JonasRadtke/128x32_VFD_Badge/128x32_VFD_Badge.kicad_pcb

## KiCad design 128x32_VFD_Badge.kicad_pcb (2025-07-06)

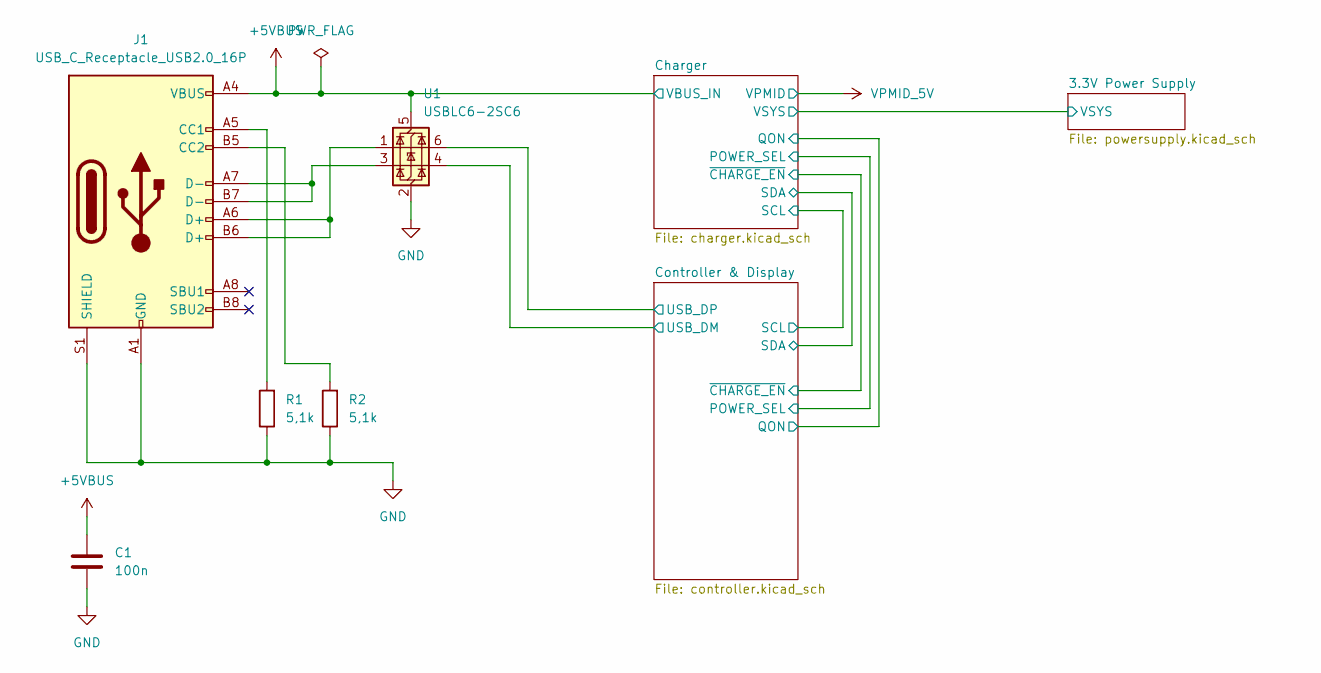
[picture p1: schematic 128x32_VFD_Badge.kicad_sch]

Parts:
C1: 100n; C_0603_1608Metric; Voltage 5V
J1: USB_C_Receptacle_USB2.0_16P; TYPE-C-31-M-14
R1, R2: 5,1k; R_0603_1608Metric
U1: USBLC6-2SC6; SOT-23-6

Connections:
+5VBUS: C1.1, J1.A4 (VBUS), J1.A9 (VBUS), J1.B4 (VBUS), J1.B9 (VBUS), U1.5 (VBUS); also elsewhere on the board
/Controller & Display/USB_DM: U1.4 (I/O2); also elsewhere on the board
/Controller & Display/USB_DP: U1.6 (I/O1); also elsewhere on the board
GND: C1.2, J1.A1 (GND), J1.A12 (GND), J1.B1 (GND), J1.B12 (GND), J1.S1 (SHIELD), R1.1, R2.1, U1.2 (GND); also elsewhere on the board
unnamed: J1.A5 (CC1), R1.2
unnamed: J1.B5 (CC2), R2.2
unnamed: J1.A6 (D+), J1.B6 (D+), U1.1 (I/O1)
unnamed: J1.A7 (D-), J1.B7 (D-), U1.3 (I/O2)

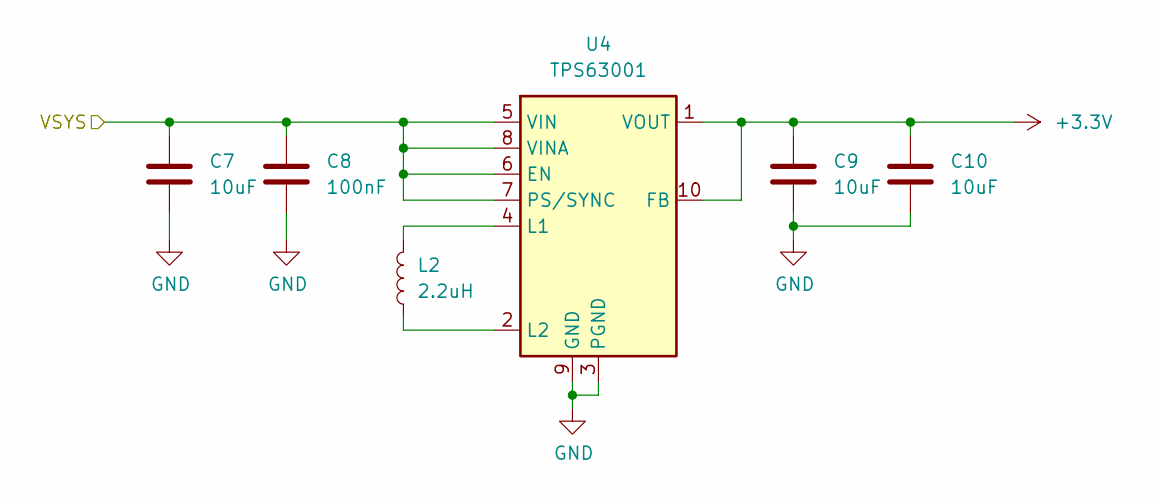
[picture p2: schematic powersupply.kicad_sch]

Parts:
C7, C9, C10: 10uF; C_0603_1608Metric; Voltage 10V
C8: 100nF; C_0603_1608Metric; Voltage 10V
L2: 2.2uH; L_Vishay_IHLP-1616
U4: TPS63001; Texas_DRC0010J_ThermalVias

Connections:
+3.3V: C9.1, C10.1, U4.1 (VOUT), U4.10 (FB); also elsewhere on the board
/3.3V Power Supply/VSYS: C7.1, C8.1, U4.5 (VIN), U4.6 (EN), U4.7 (PS/SYNC), U4.8 (VINA); also elsewhere on the board
GND: C7.2, C8.2, C9.2, C10.2, U4.3 (PGND), U4.9 (GND), U4.11 (PGND); also elsewhere on the board
unnamed: L2.2, U4.4 (L1)
unnamed: L2.1, U4.2 (L2)

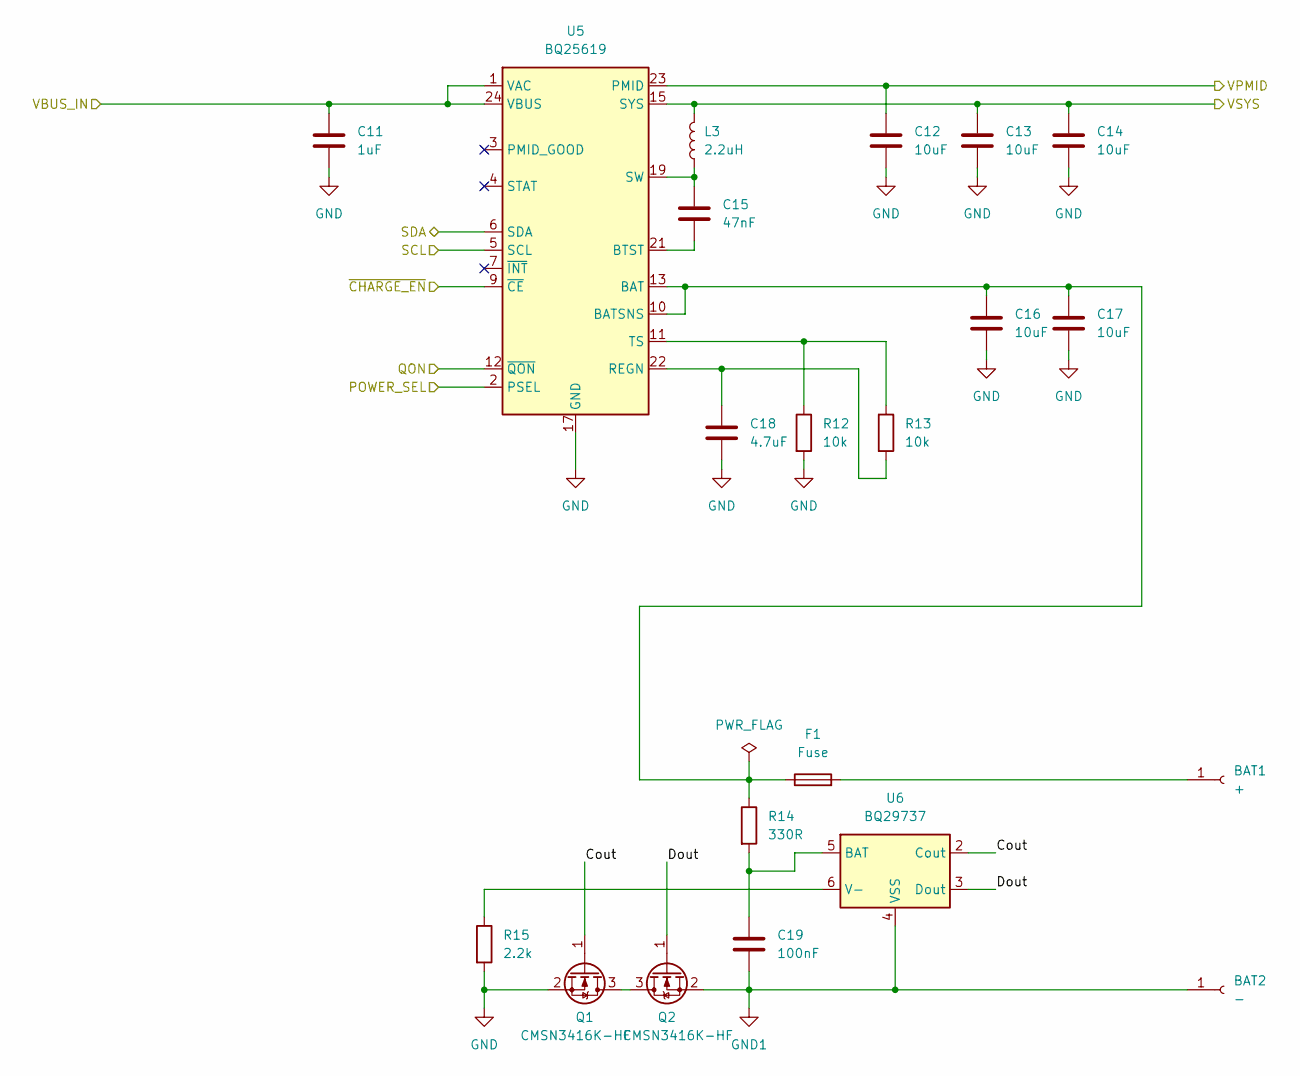
[picture p3: schematic charger.kicad_sch]

Parts:
BAT1: +; BatteryClip_Keystone_54_D16-19mm
BAT2: -; BatteryClip_Keystone_54_D16-19mm
C11: 1uF; C_0603_1608Metric; Voltage 10V
C12, C13, C14, C16, C17: 10uF; C_0603_1608Metric; Voltage 10V
C15: 47nF; C_0603_1608Metric
C18: 4.7uF; C_0603_1608Metric; Voltage 10V
C19: 100nF; C_0603_1608Metric; Voltage 10V
F1: Fuse; Fuse_1206_3216Metric
L3: 2.2uH; L_Vishay_IHLP-1616
Q1, Q2: CMSN3416K-HF; SOT-23
R12, R13: 10k; R_0603_1608Metric
R14: 330R; R_0603_1608Metric
R15: 2.2k; R_0603_1608Metric
U5: BQ25619; WQFN-24-1EP_4x4mm_P0.5mm_EP2.6x2.6mm_ThermalVias
U6: BQ29737; WSON-6_1.5x1.5mm_P0.5mm

Connections:
+5VBUS: C11.1, U5.1 (VAC), U5.24 (VBUS); also elsewhere on the board
/3.3V Power Supply/VSYS: C13.1, C14.1, L3.2, U5.15 (SYS), U5.16 (SYS); also elsewhere on the board
/Charger/Cout: Q1.1 (G), U6.2 (Cout)
/Charger/Dout: Q2.1 (G), U6.3 (Dout)
/Charger/POWER_SEL: U5.2 (PSEL); also elsewhere on the board
/Charger/QON: U5.12 (~QON); also elsewhere on the board
/Charger/SCL: U5.5 (SCL); also elsewhere on the board
/Charger/SDA: U5.6 (SDA); also elsewhere on the board
/Charger/~CHARGE_EN: U5.9 (~CE); also elsewhere on the board
BAT: C16.1, C17.1, F1.1, R14.1, U5.10 (BATSNS), U5.13 (BAT), U5.14 (BAT)
GND: C11.2, C12.2, C13.2, C14.2, C16.2, C17.2, C18.2, Q1.2 (S), R12.2, R15.2, U5.17 (GND), U5.18 (GND), U5.25 (GND); also elsewhere on the board
GND1: BAT2.1, C19.2, Q2.2 (S), U6.4 (VSS)
unnamed: BAT1.1, F1.2
unnamed: C15.1, L3.1, U5.19 (SW), U5.20 (SW)
unnamed: Q1.3 (D), Q2.3 (D)
unnamed: C15.2, U5.21 (BTST)
unnamed: C18.1, R13.2, U5.22 (REGN)
unnamed: R12.1, R13.1, U5.11 (TS)
unnamed: C19.1, R14.2, U6.5 (BAT)
unnamed: R15.1, U6.6 (V-)
VPMID_5V: C12.1, U5.23 (PMID); also elsewhere on the board

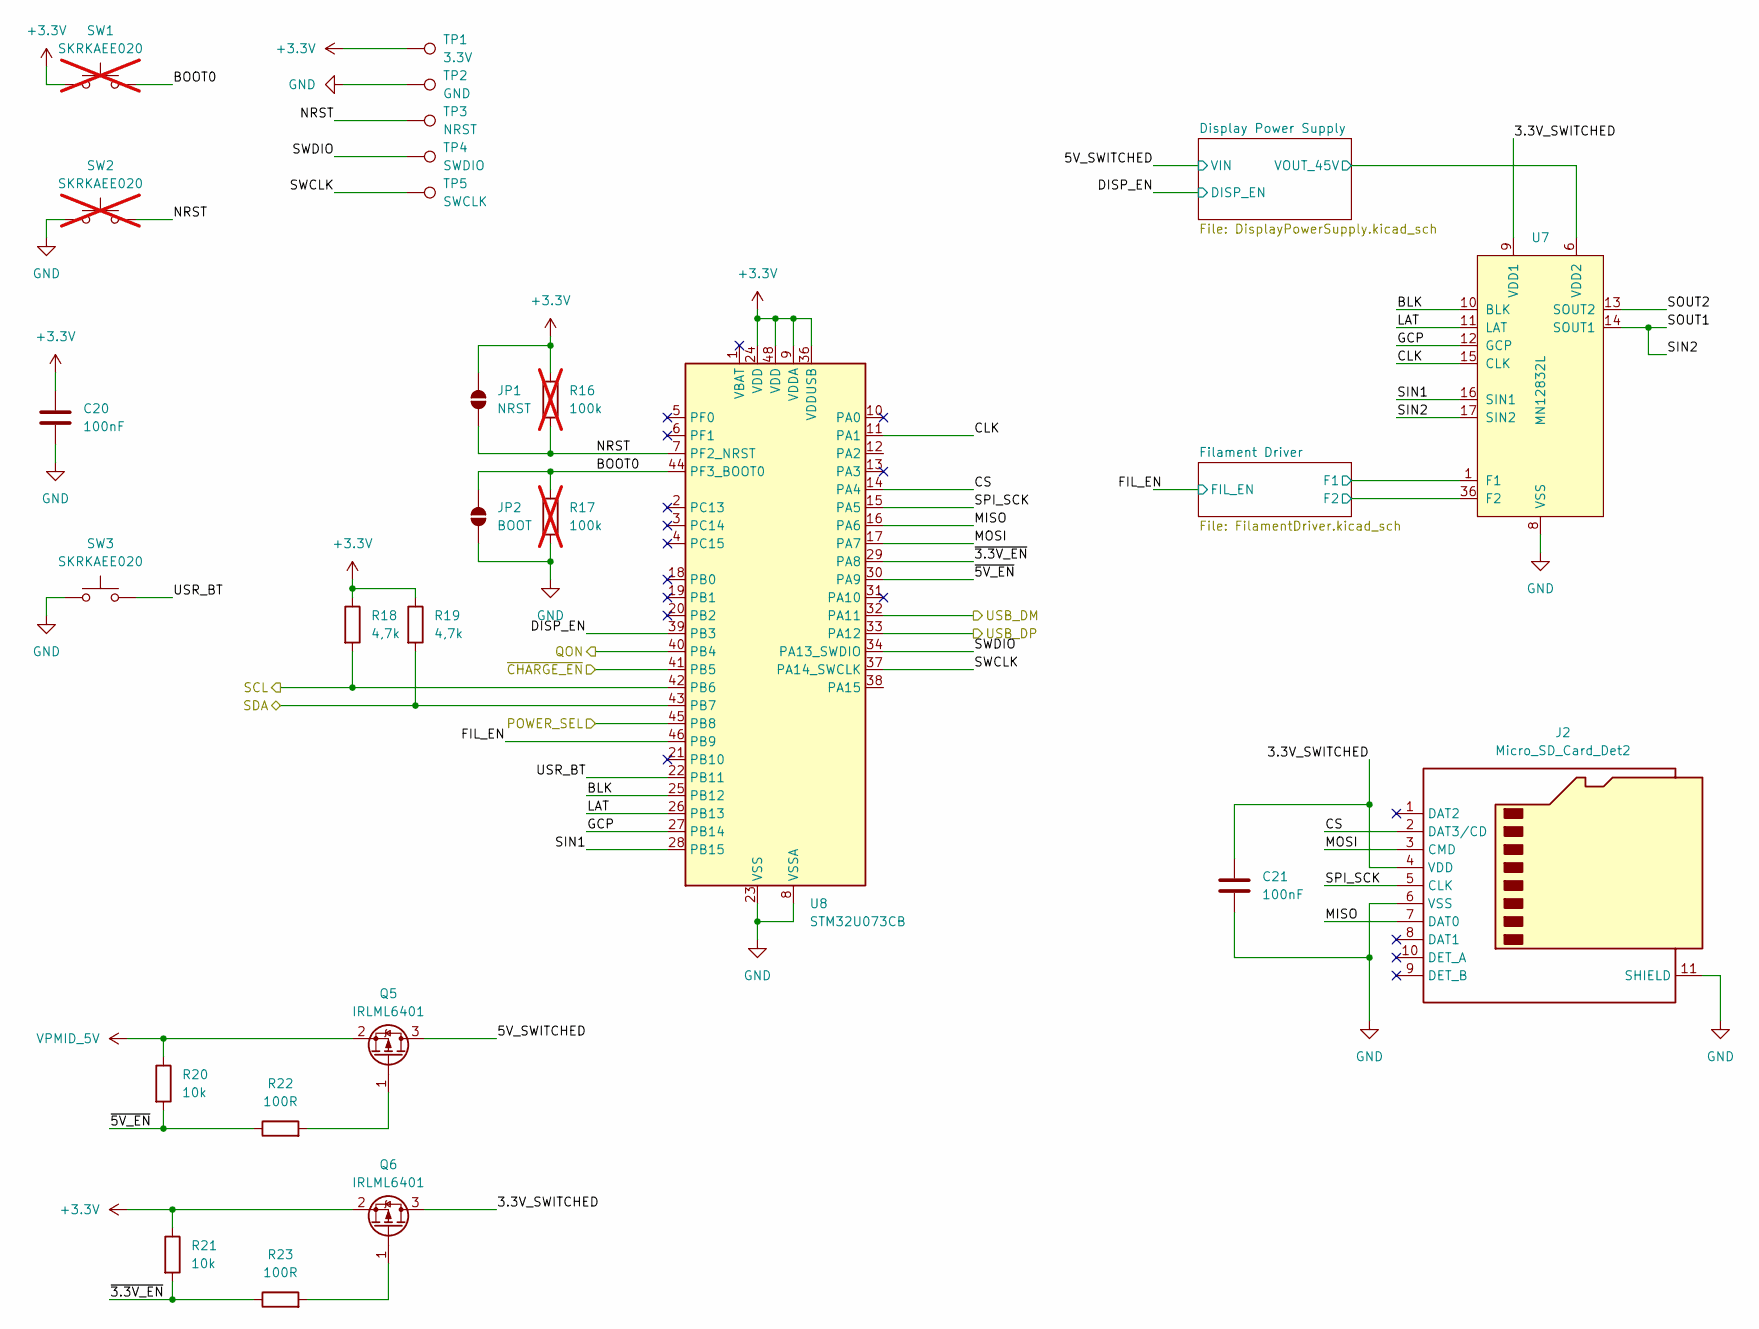
[picture p4: schematic controller.kicad_sch]

Parts:
C20, C21: 100nF; C_0603_1608Metric; Voltage 10V
J2: Micro_SD_Card_Det2; microSD_HC_Molex_104031-0811
JP1: NRST; SolderJumper-2_P1.3mm_Open_TrianglePad1.0x1.5mm
JP2: BOOT; SolderJumper-2_P1.3mm_Open_TrianglePad1.0x1.5mm
Q5, Q6: IRLML6401; SOT-23
R16, R17: 100k; R_0603_1608Metric; not fitted
R18, R19: 4,7k; R_0603_1608Metric
R20, R21: 10k; R_0603_1608Metric
R22, R23: 100R; R_0603_1608Metric
SW1, SW2: SKRKAEE020; SW_Push_SPST_NO_Alps_SKRK; not fitted
SW3: SKRKAEE020; SW_Push_SPST_NO_Alps_SKRK
TP1: 3.3V; TestPoint_Pad_D1.0mm
TP2: GND; TestPoint_Pad_D1.0mm
TP3: NRST; TestPoint_Pad_D1.0mm
TP4: SWDIO; TestPoint_Pad_D1.0mm
TP5: SWCLK; TestPoint_Pad_D1.0mm
U7: MN12832L
U8: STM32U073CB; LQFP-48_7x7mm_P0.5mm

Connections:
+3.3V: C20.1, JP1.2 (B), Q6.2 (S), R16.1, R18.1, R19.1, R21.1, SW1.1, TP1.1, U8.9 (VDDA), U8.24 (VDD), U8.36 (VDDUSB), U8.48 (VDD); also elsewhere on the board
+45V: U7.6 (VDD2); also elsewhere on the board
/Charger/POWER_SEL: U8.45 (PB8); also elsewhere on the board
/Charger/QON: U8.40 (PB4); also elsewhere on the board
/Charger/SCL: R18.2, U8.42 (PB6); also elsewhere on the board
/Charger/SDA: R19.2, U8.43 (PB7); also elsewhere on the board
/Charger/~CHARGE_EN: U8.41 (PB5); also elsewhere on the board
/Controller & Display/3.3V_SWITCHED: C21.1, J2.4 (VDD), Q6.3 (D), U7.9 (VDD1)
/Controller & Display/5V_SWITCHED: Q5.3 (D); also elsewhere on the board
/Controller & Display/BLK: U7.10 (BLK), U8.25 (PB12)
/Controller & Display/BOOT0: JP2.2 (B), R17.1, SW1.2, U8.44 (PF3_BOOT0)
/Controller & Display/CLK: U7.15 (CLK), U8.11 (PA1)
/Controller & Display/CS: J2.2 (DAT3/CD), U8.14 (PA4)
/Controller & Display/DISP_EN: U8.39 (PB3); also elsewhere on the board
/Controller & Display/FIL_EN: U8.46 (PB9); also elsewhere on the board
/Controller & Display/Filament Driver/F1: U7.1 (F1), U7.2 (F1), U7.3 (F1); also elsewhere on the board
/Controller & Display/Filament Driver/F2: U7.36 (F2), U7.37 (F1), U7.38 (F1); also elsewhere on the board
/Controller & Display/GCP: U7.12 (GCP), U8.27 (PB14)
/Controller & Display/LAT: U7.11 (LAT), U8.26 (PB13)
/Controller & Display/MISO: J2.7 (DAT0), U8.16 (PA6)
/Controller & Display/MOSI: J2.3 (CMD), U8.17 (PA7)
/Controller & Display/NRST: JP1.1 (A), R16.2, SW2.2, TP3.1, U8.7 (PF2_NRST)
/Controller & Display/SIN1: U7.16 (SIN1), U8.28 (PB15)
/Controller & Display/SIN2: U7.14 (SOUT1), U7.17 (SIN2)
/Controller & Display/SOUT2: U7.13 (SOUT2)
/Controller & Display/SPI_SCK: J2.5 (CLK), U8.15 (PA5)
/Controller & Display/SWCLK: TP5.1, U8.37 (PA14_SWCLK)
/Controller & Display/SWDIO: TP4.1, U8.34 (PA13_SWDIO)
/Controller & Display/USB_DM: U8.32 (PA11); also elsewhere on the board
/Controller & Display/USB_DP: U8.33 (PA12); also elsewhere on the board
/Controller & Display/USR_BT: SW3.2, U8.22 (PB11)
/Controller & Display/~3.3V_EN: R21.2, R23.1, U8.29 (PA8)
/Controller & Display/~5V_EN: R20.2, R22.1, U8.30 (PA9)
GND: C20.2, C21.2, J2.6 (VSS), J2.11 (SHIELD), JP2.1 (A), R17.2, SW2.1, SW3.1, TP2.1, U7.7 (VSS), U7.8 (VSS), U8.8 (VSSA), U8.23 (VSS), U8.35 (VSS), U8.47 (VSS); also elsewhere on the board
unnamed: Q5.1 (G), R22.2
unnamed: Q6.1 (G), R23.2
VPMID_5V: Q5.2 (S), R20.1; also elsewhere on the board

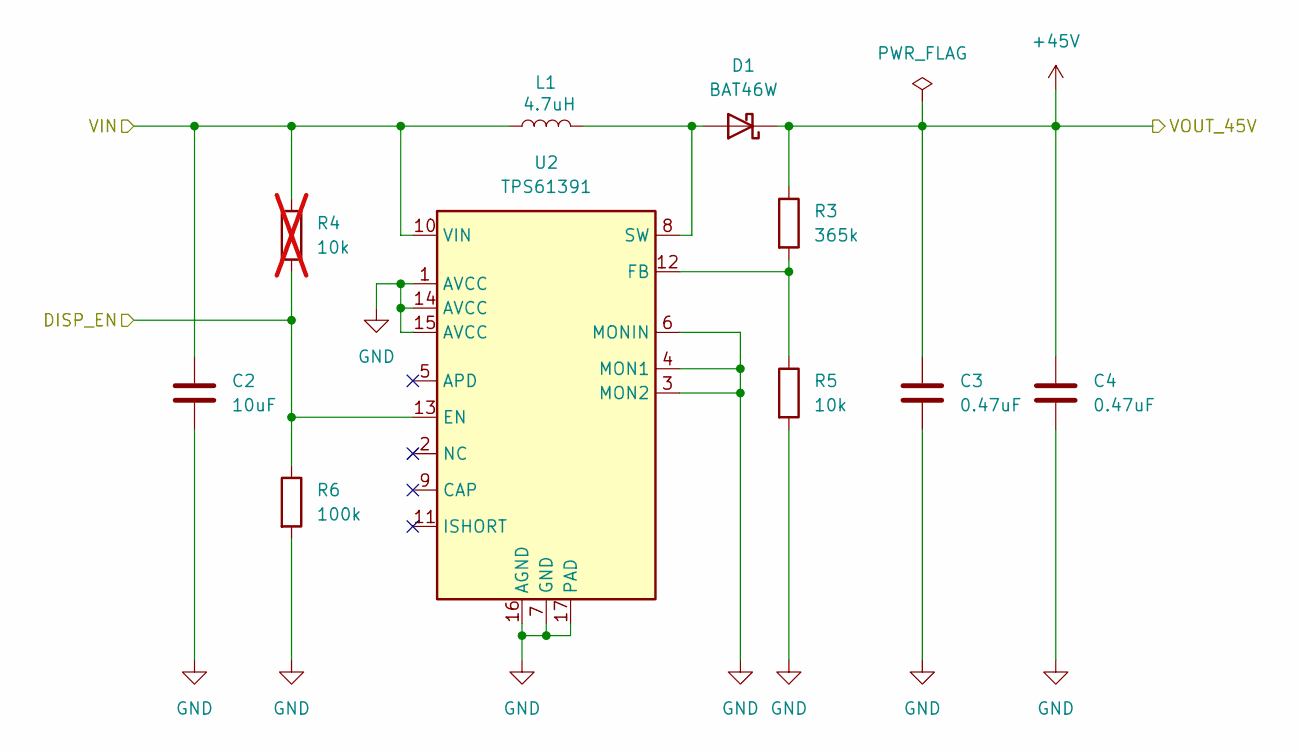
[picture p5: schematic DisplayPowerSupply.kicad_sch]

Parts:
C2: 10uF; C_0603_1608Metric; Voltage 10V
C3, C4: 0.47uF; C_0603_1608Metric; Voltage 50V
D1: BAT46W; D_SOD-123F
L1: 4.7uH; L_Vishay_IHLP-1616
R3: 365k; R_0603_1608Metric
R4: 10k; R_0603_1608Metric; not fitted
R5: 10k; R_0603_1608Metric
R6: 100k; R_0603_1608Metric
U2: TPS61391; WQFN-16-1EP_3x3mm_P0.5mm_EP1.6x1.6mm_ThermalVias

Connections:
+45V: C3.1, C4.1, D1.1 (K), R3.1; also elsewhere on the board
/Controller & Display/5V_SWITCHED: C2.1, L1.1, R4.1, U2.10 (VIN); also elsewhere on the board
/Controller & Display/DISP_EN: R4.2, R6.1, U2.13 (EN); also elsewhere on the board
GND: C2.2, C3.2, C4.2, R5.2, R6.2, U2.1 (AVCC), U2.3 (MON2), U2.4 (MON1), U2.6 (MONIN), U2.7 (GND), U2.14 (AVCC), U2.15 (AVCC), U2.16 (AGND), U2.17 (PAD); also elsewhere on the board
unnamed: D1.2 (A), L1.2, U2.8 (SW)
unnamed: R3.2, R5.1, U2.12 (FB)

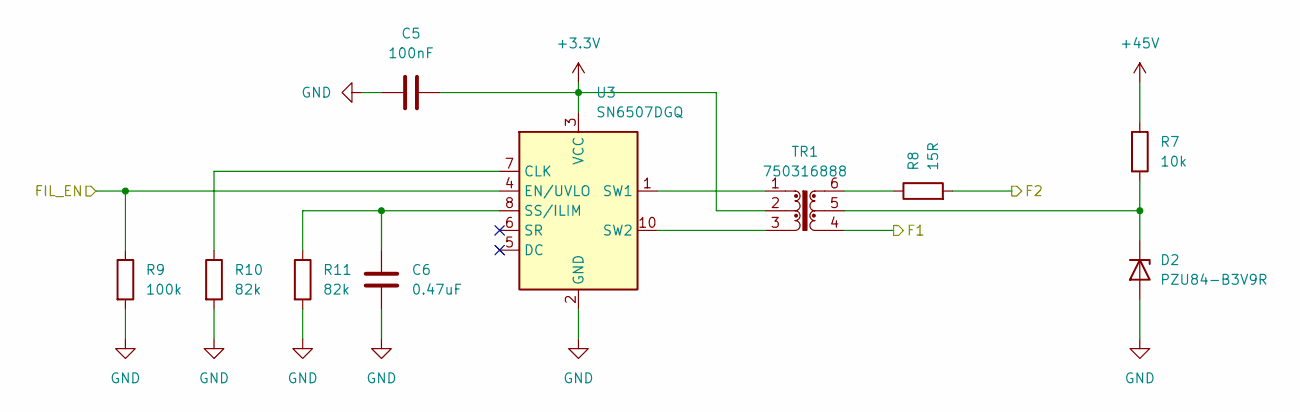
[picture p6: schematic FilamentDriver.kicad_sch]

Parts:
C5: 100nF; C_0603_1608Metric; Voltage 10V
C6: 0.47uF; C_0603_1608Metric; Voltage 10V
D2: PZU84-B3V9R; SOT-23-3
R7: 10k; R_0603_1608Metric
R8: 15R; R_0603_1608Metric
R9: 100k; R_0603_1608Metric
R10, R11: 82k; R_0603_1608Metric
TR1: 750316888; Transformer_Wuerth_750316888
U3: SN6507DGQ; HVSSOP-10-1EP_3x3mm_P0.5mm_EP1.57x1.88mm

Connections:
+3.3V: C5.2, TR1.2, U3.3 (VCC); also elsewhere on the board
+45V: R7.1; also elsewhere on the board
/Controller & Display/FIL_EN: R9.1, U3.4 (EN/UVLO); also elsewhere on the board
/Controller & Display/Filament Driver/F1: TR1.4; also elsewhere on the board
/Controller & Display/Filament Driver/F2: R8.2; also elsewhere on the board
GND: C5.1, C6.2, D2.1 (A), R9.2, R10.2, R11.2, U3.2 (GND), U3.9 (GND); also elsewhere on the board
unnamed: D2.3 (K), R7.2, TR1.5
unnamed: R8.1, TR1.6
unnamed: R10.1, U3.7 (CLK)
unnamed: C6.1, R11.1, U3.8 (SS/ILIM)
unnamed: TR1.1, U3.1 (SW1)
unnamed: TR1.3, U3.10 (SW2)

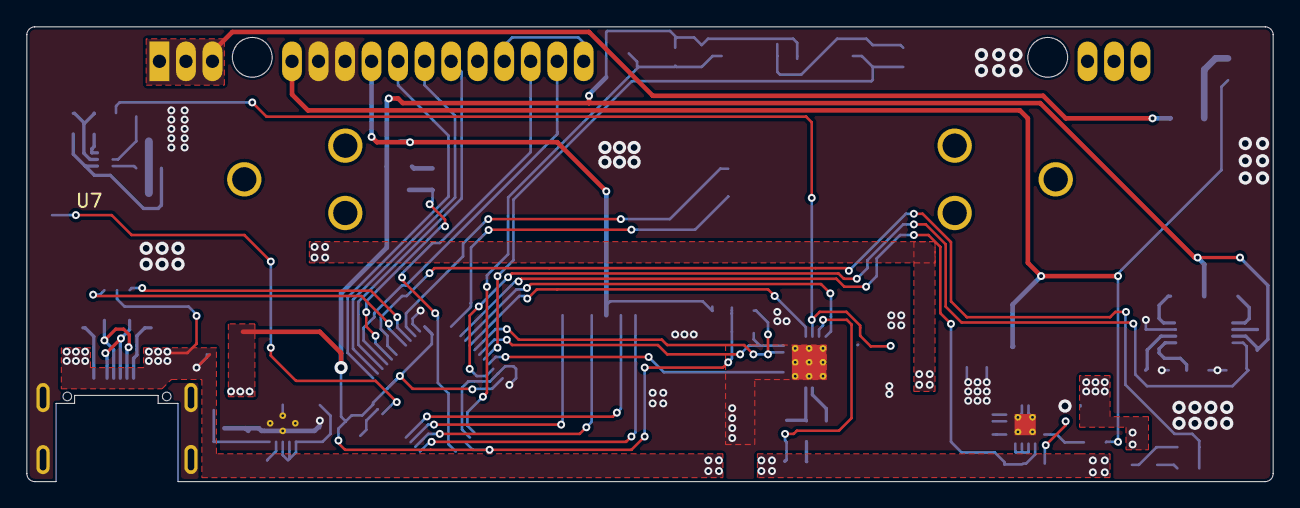
[picture p7: board 128x32_VFD_Badge.kicad_pcb from above]

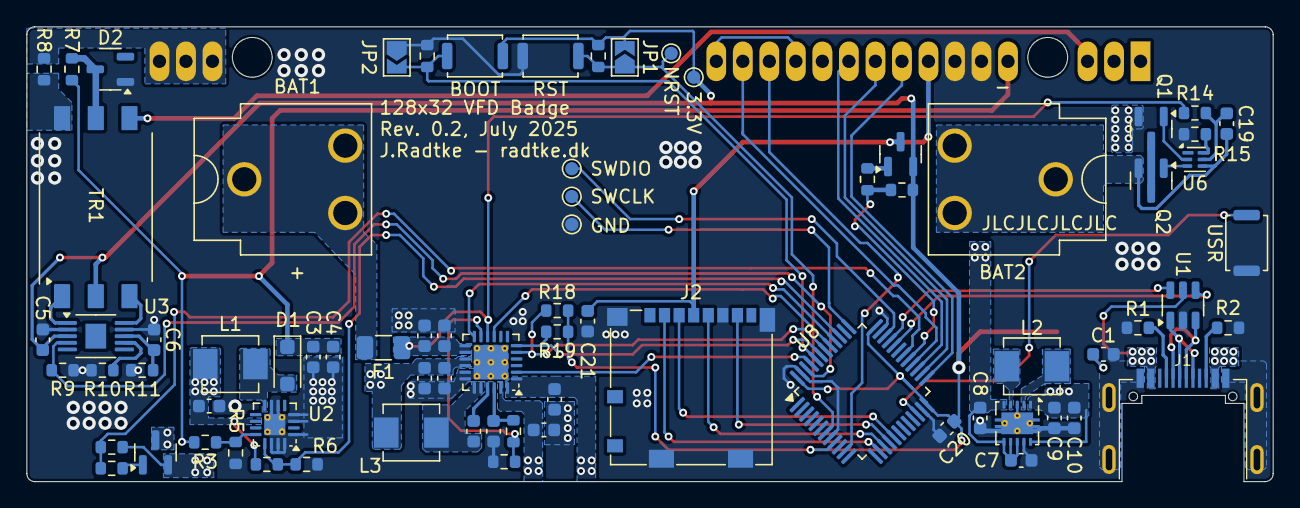
[picture p8: board 128x32_VFD_Badge.kicad_pcb from below]

Board: 2 copper layers, 94.0 x 34.3 mm, 77 parts (76 on the bottom side), 64 nets.
