JonasRadtke/128x32_VFD_Badge/(commit log)

2025-05-15 Rev 0.1
    [128x32_VFD_Badge.kicad_pcb, 128x32_VFD_Badge.kicad_sch, FilamentDriver.kicad_sch, controller.kicad_sch]
2025-07-06 spi_pins
    VFD over SPI
    3.3V and 5V over P-Channel Mosfet
    [128x32_VFD_Badge.kicad_pcb, controller.kicad_sch]
